ducanh28807-prog/SmartBlindCane/Images/Smartblindcane2.jpg

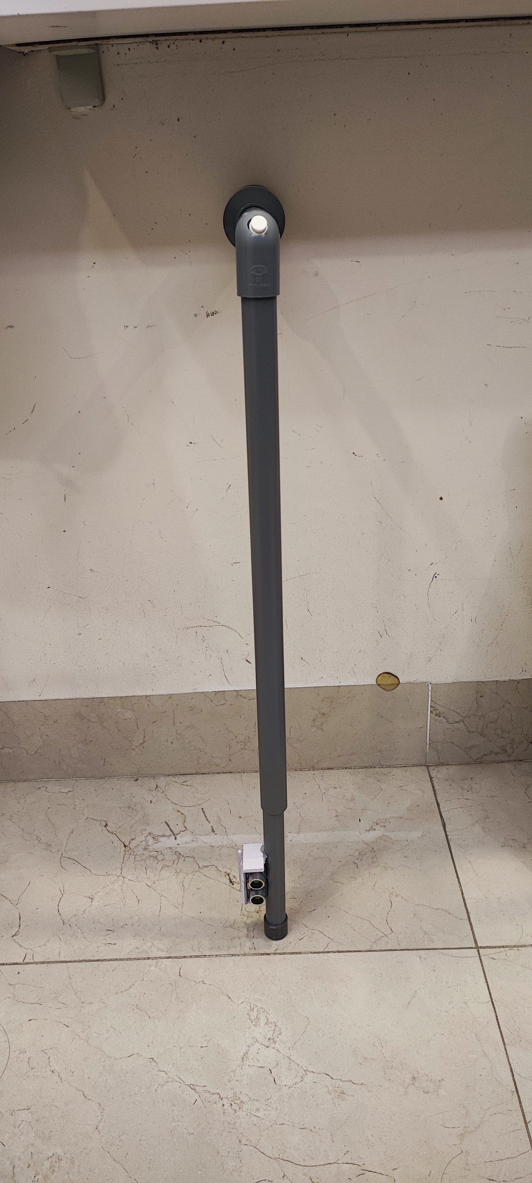
Images/Smartblindcane2.jpg
