ducanh28807-prog/SmartBlindCane/Images/Smartblindcane4.jpg

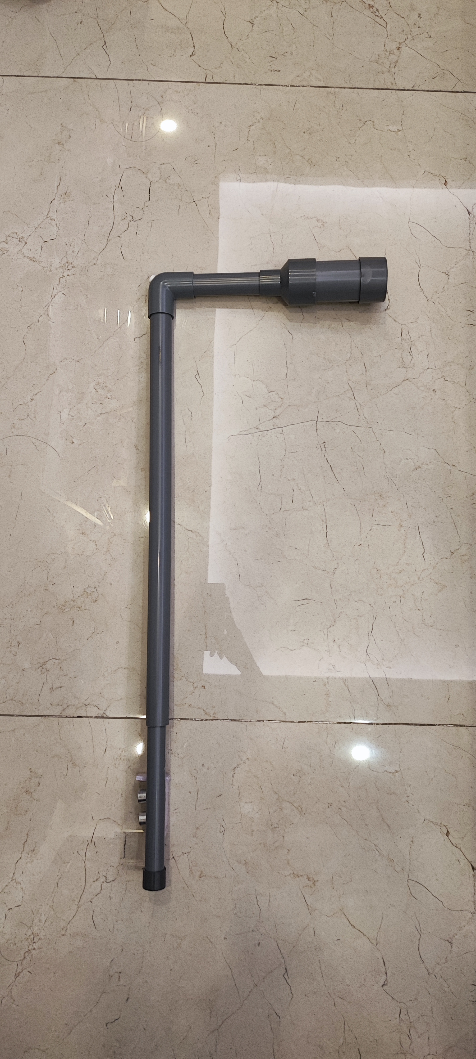
Images/Smartblindcane4.jpg
