ducanh28807-prog/SmartBlindCane/Images/AlgorithmBlock_diagram.png

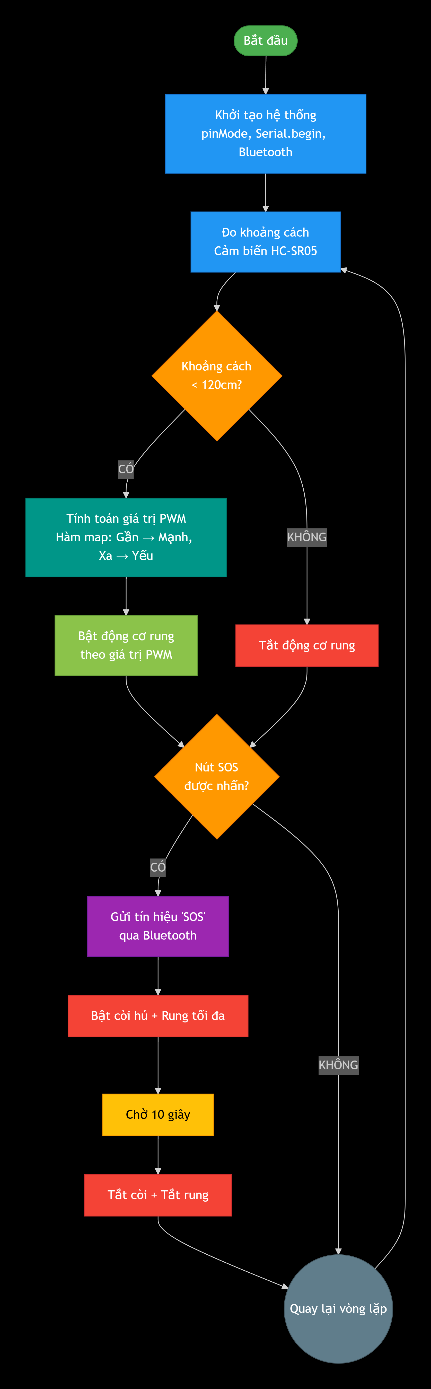
Images/AlgorithmBlock_diagram.png
