ducanh28807-prog/SmartBlindCane/Images/Smartblindcane1.jpg

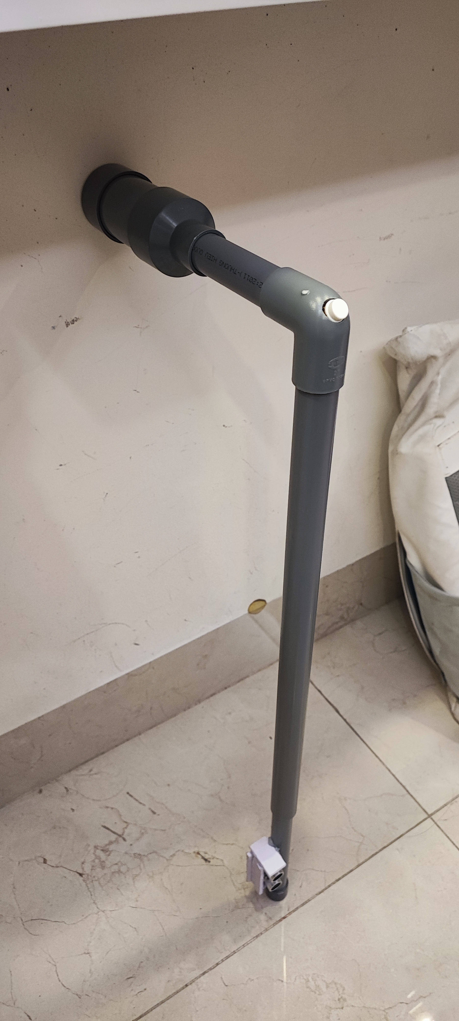
Images/Smartblindcane1.jpg
