ducanh28807-prog/SmartBlindCane/Images/Smartblindcane3.jpg

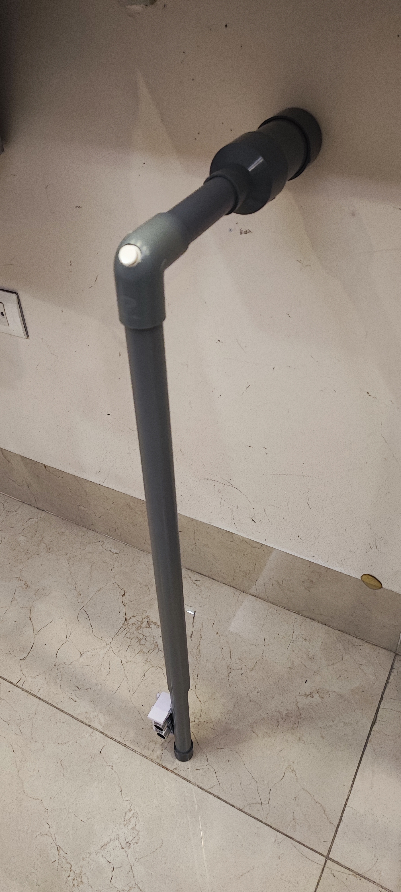
Images/Smartblindcane3.jpg
