ducanh28807-prog/SmartBlindCane/Images/SystemBlock_diagram.png

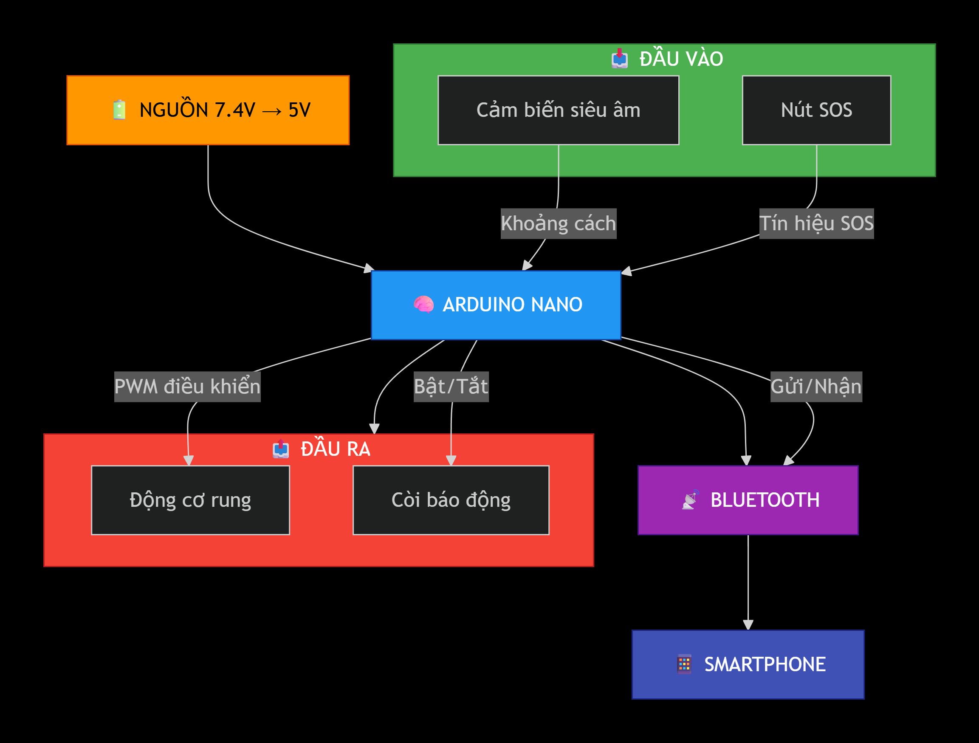
Images/SystemBlock_diagram.png
